hp2380/ultrasonic-radar-arduino/(commit log)

2026-07-25 Complete ultrasonic radar system with Processing visualization
2026-07-25 Rename wiring diagram
2026-07-25 Fix wiring diagram link
2026-09-03 Fix: mount sensor on servo horn - previous angular data was invalid
    [radar.ino.ino, radar_display.pde, radar_logger.ino]
